mhagensiena/Cloud-Chamber-Siena-University/README.md

# Cloud-Chamber-Siena-University
The instructions to build your own desktop cloud chamber with no dry ice! All for under $200!

Download this file and open in browser:
<a href="Thorium-232%20Decay%20Chain%20Lab.html">Lab</a>
