mhagensiena/Cloud-Chamber-Siena-University/2026/overview.md

What exactly is a Cloud Chamber? How does it work? Am I really seeing particles?

A cloud chamber is a small particle detector, but you aren't seeing the particle itself. You are seeing the track left by the particle. 
The "chamber" that we create is made to reach extremely cold temperatures using devices that absorb heat such as the cooling fan and peltiers. 
The heat transfer is made more efficient using thermal paste. Then by adding the alcohol to the chamois cloth, we see alcohol vapor. 
As the particle travels through the air, the air becomes ionized, so the alcohol condenses around that air. This is how we see the track of the particle.
