mhagensiena/Cloud-Chamber-Siena-University/2026/Images/IMG_4949 2.jpeg

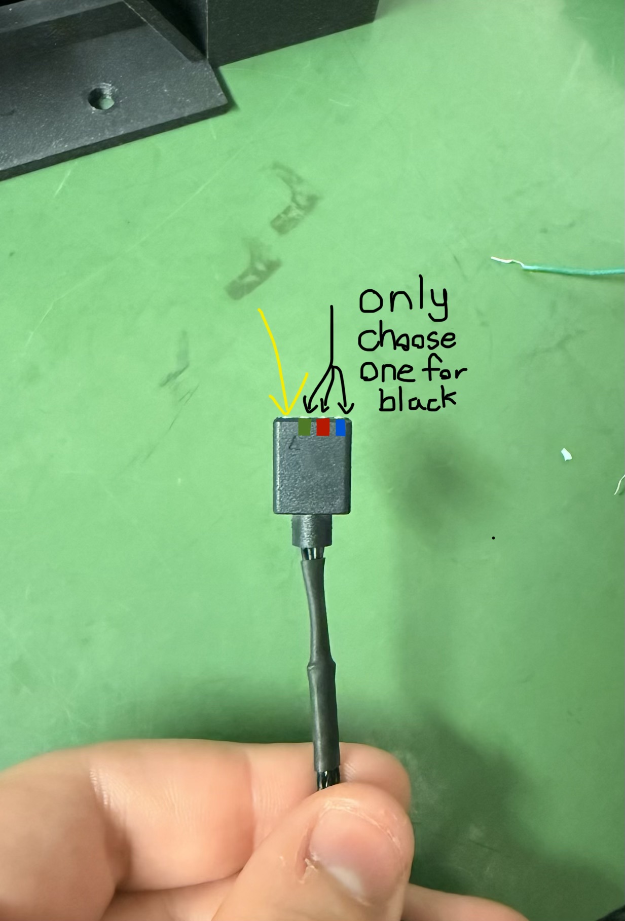
2026/Images/IMG_4949 2.jpeg
