mhagensiena/Cloud-Chamber-Siena-University/2026/Images/IMG_5046.jpeg

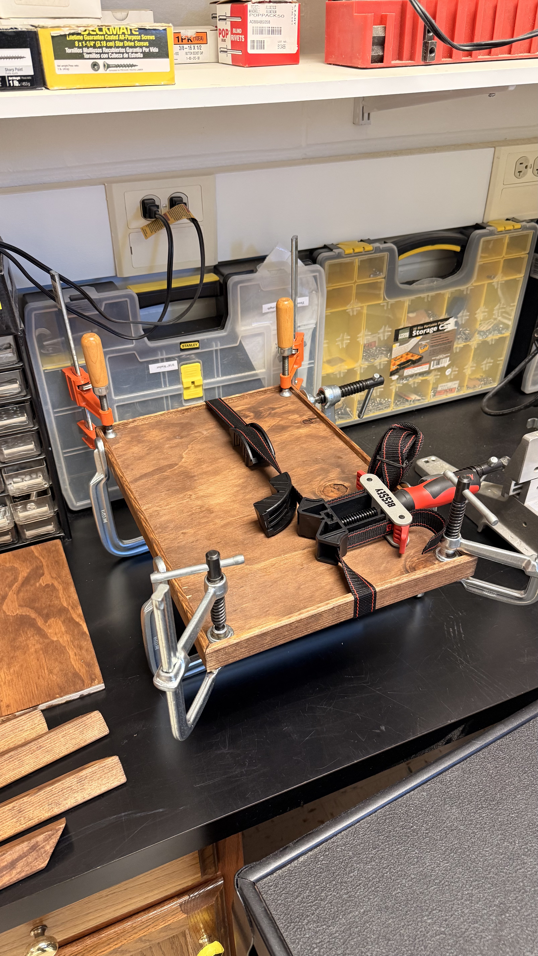
2026/Images/IMG_5046.jpeg
