mhagensiena/Cloud-Chamber-Siena-University/2026/Materials.md

# Materials & Components

<p align="center">
Everything required to build the Siena University Cloud Chamber.
</p>

---

## Quick Navigation
<h2 align="center">Quick Navigation</h2>

<p align="center"> •
  <a href="#wood--hardware">wood--hardware</a> •
  <a href="#electrical-components">electrical-components</a> •
  <a href="#cooling-components">cooling-components</a> •
  <a href="#chamber-components">chamber-components</a> •
  <a href="#recommended-tools">recommended-tools</a> •
</p>

---

<h2 id="wood--hardware" align="center">Wood & Hardware</h2>

| Component | Qty | Purchase Link |
| --- | --- | --- |
| Plywood (16" × 11", 1/2" thick minimum) | 1 | [Lowes](https://www.lowes.com/pd/1-4-in-Common-Pine-Sanded-Plywood-Application-as-2-x-2/1000068959) |
| Adjustable Feet | 4 | [Home Depot](https://www.homedepot.com/p/Everbilt-1-1-16-in-Round-Threaded-Stem-Leveling-Furniture-Glides-for-Floor-Protection-4-Pack-4603644EB/203672161)  |
| Black Handles | 2 | [Amazon](https://www.amazon.com/Cable-Lokman-Stainless-Rubber-Cushioned/dp/B01N0750PI?th=1) |
| Rubber/Wood Edging (Optional) | As Needed | [Lowes](https://www.lowes.com/pd/KidKusion-Taupe-Foam-Corner-Cushions-4-Pack-Child-Safety-Accessories-for-Tables-Countertops-and-Fireplace-Hearths/1083701) |
| #4-40 × 1" Oval Head Phillips Screws | As Needed | [Home Deopt](https://www.homedepot.com/p/Hillman-4-40-x-1-in-Phillips-Pan-Head-Machine-Screws-50-Pack-43067/204794818)  |

| #6-32 × 1" Flat Head Phillips Screws    | As Needed | [Home Deopt](https://www.homedepot.com/p/Everbilt-6-32-x-1-in-Combo-Round-Head-Zinc-Plated-Machine-Screw-100-Pack-800692/204596455)  |
| #8 × 3/4" Flat Phillips Screws          | As Needed | [Home Deopt](https://www.homedepot.com/p/Hillman-18-8-Stainless-Steel-Flat-Head-Phillips-Machine-Screw-8-32-x-3-4-in-8454/204775174 ) |

| Cable Clamp                             | 1         | [Amazon](https://www.amazon.com/Cable-Lokman-Stainless-Rubber-Cushioned/dp/B01N0750PI)                                                                      |
| Black Spray Paint                       | 1 Can     | [Walmart](https://www.walmart.com/ip/488512581)                                                                                                             |

<p align="right"><a href="#top"> Back to Top</a></p>

---

<h2 id="electrical-components" align="center"> Electrical Components</h2>

| Component | Qty | Purchase Link |
| --- | --- | --- |
| Be Quiet! PURE POWER 13 M 750W Power Supply | 1 | Existing / Retailer |
| 24-Pin Colored Adapter | 1 | [Amazon](https://www.amazon.com/ZYAMY-Female-Computer-Power-Adapter/dp/B081RPV4N6) |
| Waterproof LED Strip Lights | 1 | [Amazon](https://www.amazon.com/Flexible-Waterproof-Holiday-Outdoor-Decoration/dp/B075R4X1XL) |
| LED Strip Connectors | As Needed | [Amazon](https://www.amazon.com/Connector-Waterproof-Connectors-Transparent-Solderless/dp/B0BG41H9LJ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) |
| Lever Nuts | As Needed | [Amazon](https://www.amazon.com/dp/B08W3QXN9B) |
| Thin Wire | As Needed | Existing Supply |
| Electrical Tape | 1 Roll | [Lowes](https://www.lowes.com/pd/Scotch-700-Electrical-Tape-66-ft/50148224) |

<p align="right"><a href="#top"> Back to Top</a></p>

---

<h2 id="cooling-components" align="center"> Cooling Components</h2>

| Component | Qty | Purchase Link |
| --- | --- | --- |
| Hyper 212 RGB Black Edition Cooler | 1 | [Amazon](https://www.amazon.com/Cooler-Master-Spectrum-Brackets-RR-S4NA-17PA-R1/dp/B0BRBW94VL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) |
| TEC1-12709 Peltier Module | 1 | [Amazon](https://www.amazon.com/SMAKN-TEC1-12709-Thermoelectric-Peltier-138-6Wmax/dp/B00MTFB84Q) |
| TEC1-12710 Peltier Module | 1 |[Amazon](https://www.amazon.com/Alinan-TEC1-12709-Semiconductor-Refrigeration-Thermoelectric/dp/B09M7V92WK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) |
| Arctic Silver 5 or Arctic MX-5 Thermal Paste | 1 Tube | [Amazon](https://www.amazon.com/Arctic-Silver-AS5-3-5G-Thermal-Paste/dp/B000OGX5AM) |

<p align="right"><a href="#top"> Back to Top</a></p>

---

<h2 id="chamber-components" align="center"> Chamber Components</h2>

| Component | Qty | Purchase Link |
| --- | --- | --- |
| 100 mm Petri Dish | 1 | [Amazon](https://www.amazon.com/Disposable-Petri-Dish-35mm-Polystyrene/dp/B07WLLB2XB) |
| Chamois Cloth | 1 | [Amazon](https://www.amazon.com/AmazonBasics-Drying-Chamois-2-Pack/dp/B00EVY344K) |
| Isopropyl Alcohol (90%+) | 1 Bottle  | [Amazon](https://www.amazon.com/Amazon-Brand-Isopropyl-Alcohol-Antiseptic/dp/B07NFTZ522) |
| Thoriated Tungsten Rod | 1 | [Tungsten.com](https://shop.tungsten.com/tig-welding-electrodes-10-pack) |
| Super Glue | 1 | Local Retailer |
| Washers | As Needed | [Home Deopt](https://www.homedepot.com/p/Everbilt-6-Zinc-Plated-Flat-Washer-100-Pieces-19792/202249725#see-more-details) |

<p align="right"><a href="#top"> Back to Top</a></p>

---

<h2 id="recommended-tools" align="center"> Recommended Tools</h2>

* Drill
* Assorted Drill Bits
* Soldering Iron
* Solder
* Wire Strippers
* Phillips Screwdriver
* Measuring Tape
* Clamps
* Saw
* Utility Knife
* Infrared Thermometer (Recommended)
* Hot Glue Gun (Optional)

---

> [!TIP]
> Before beginning assembly, verify that all materials and tools are available. Having everything prepared beforehand will make the build process significantly smoother.

> [!WARNING]
> This project involves electrical wiring, soldering, sharp tools, and a radioactive source. Follow all applicable safety procedures and work in a safe, well-ventilated environment.
