mhagensiena/Cloud-Chamber-Siena-University/2026/3D print parts/Cooler Fan Holder.stl

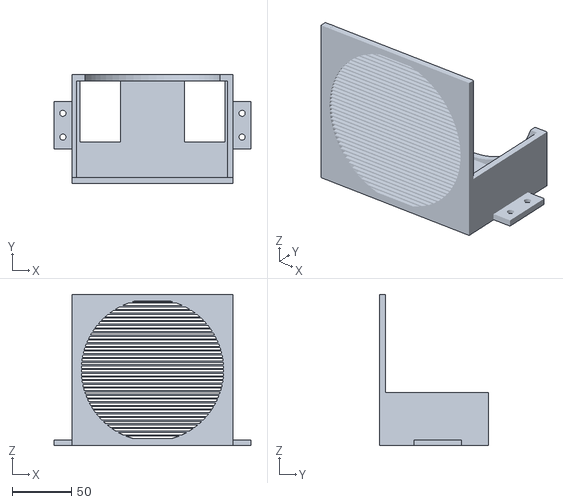
[picture p3: CAD file, 2026-06-12]
2026/3D print parts/Cooler Fan Holder.stl
166.3 x 91.6 x 127.6
