mhagensiena/Cloud-Chamber-Siena-University/2026/3D print parts/Power_Supply_Holder_Be_Quiet.stl

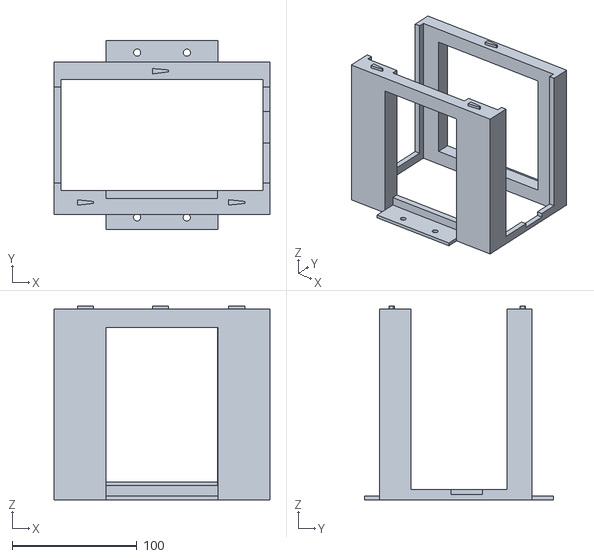
[picture p4: CAD file, 2026-06-10]
2026/3D print parts/Power_Supply_Holder_Be_Quiet.stl
173.2 x 151.9 x 155.5
