mhagensiena/Cloud-Chamber-Siena-University/2026/3D print parts/Led_Holder.stl

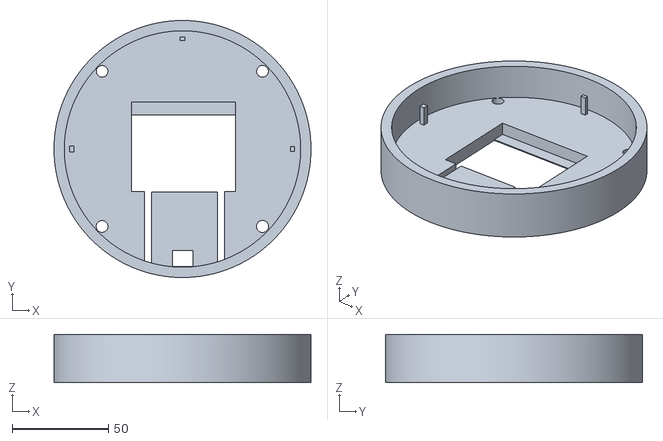
[picture p5: CAD file, 2026-06-08]
2026/3D print parts/Led_Holder.stl
133.8 x 133.8 x 25.0
