mhagensiena/Cloud-Chamber-Siena-University/2026/3D print parts/Led_cover.stl

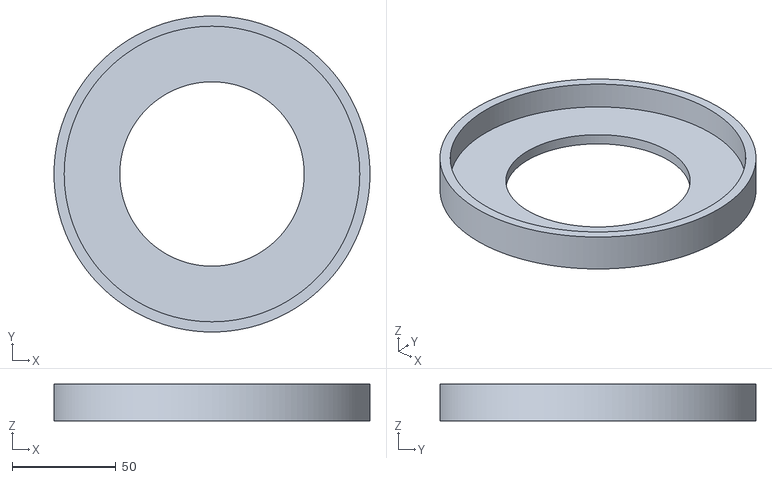
[picture p6: CAD file, 2026-06-08]
2026/3D print parts/Led_cover.stl
152.4 x 152.4 x 17.8
