mhagensiena/Cloud-Chamber-Siena-University/2016/Instructions.md

Here is a link to the instructions for 2016

 <a href="https://www.instructables.com/Cloud-Chamber-Particle-Detector/">2016 Instructions </a>
