mhagensiena/Cloud-Chamber-Siena-University/2022/instructions.md

Here is a link to the instructions from 2022

 <a href="https://https://www.instructables.com/Cloud-Chamber-Particle-Detector-2022/">2022 Instructions </a>
