mhagensiena/Cloud-Chamber-Siena-University/2025/instructions.md

Here is a link to the instructions from 2025

  <a href="https://www.instructables.com/Siena-College-Cloud-Chamber-2025/"> 2025 Instructions</a>
