mhagensiena/Cloud-Chamber-Siena-University/2026/Lab instructions.docx

# General Lab Procedures

Data Acquisition and Calibration

- Review the accompanying presentation slides [https://docs.google.com/presentation/d/1B35zL_IkINuuKQ8NIXFKNZCMMRDfD0Q6fm9fiU3JGMw/edit?usp=sharing] on data collection and analysis, as the procedures are applicable to both the Lead-210 and Cosmic Ray segments of this lab.
- Calibration Procedure: The Tracker software (https://opensourcephysics.github.io/tracker-website/) provides particle track data in pixels. To convert pixel measurements to centimeters (cm), an object of known size within the Petri dish must be measured to establish the pixels-to-cm conversion factor.
- Data Archival: All raw video files and processed data spreadsheets must be uploaded to the shared drive location (https://drive.google.com/drive/folders/1GYDYQL0rpfoI6Ljsu8_pguHJivwzpHmI?usp=drive_link)

Background Physics and Theory

- The provided presentation slides [https://docs.google.com/presentation/d/1Ke5z5PG0GqcO819rRQGf8dI0Vj1WmEbkjeAe4o_L0DA/edit?usp=sharing] cover the foundational physics and initial data analysis techniques for this experiment. Successful completion of this upper-level lab requires independent research beyond the provided materials.

# Laboratory Techniques extra material

Cosmic Ray Background Measurement

- Objective: Estimate the angular distribution of cosmic rays.
1. Data Collection (Background): Acquire multiple video recordings of the cloud chamber in the absence of the radioactive source. The goal is to detect high-energy cosmic ray tracks, characterized by strong, definite ionization paths.
  - Operational Note: Cosmic ray tracks are typically visible every 30–60 seconds. Record sufficient video time to collect a minimum of 30 distinct tracks. Excessive alcohol condensation requires wiping down the lid and possibly reapplying alcohol to the chamber.
2. Calibration Check: Confirm that the calibration required for converting pixel measurements to track length remains consistent.
3. Track Recording: Record the timestamp for each of the collected cosmic ray tracks.
4. Data Analysis & Plotting:
  - Generate a plot showing the trajectory of all observed tracks.
  - Plot the arrival time of each track versus its measured track length.
5. Angular Distribution: Estimate the incoming angle of the cosmic ray based on the track length, as discussed in the lab session. Plot the resulting angular distribution. Note: Given the minimum target of 30 tracks, the binning may be coarse.
6. Discussion Points:
  - Identify and discuss the factors that influence the accuracy of the estimated angular distribution.
  - Describe the expected shape of the angular distribution based on theoretical models and previous lab discussions.
