mhagensiena/Cloud-Chamber-Siena-University/(commit log)

2026-06-05 Add overview of cloud chamber functionality
2026-06-05 Add materials list for 2026 project
2026-06-05 Create 3D printed parts
2026-06-05 instructions for cloud chamber assembly
    Added detailed step-by-step instructions for building a cloud chamber, including preparation, assembly, and testing procedures.
2026-06-05 troubleshooting guide
    Added troubleshooting guide for common issues related to power supply, fan, peltier, LEDs, particle tracks, and mist visibility.
2026-06-08 3D printed STL Files
    [Power_Supply_Lid_Be Quite.stl, led_cover.stl, led_holder.stl, power_supply_holder_Be Quite.stl]
2026-06-08 moved stl files into their own filder
    [Power_Supply_Lid_Be Quite.stl, led_cover.stl, led_holder.stl, power_supply_holder_Be Quite.stl]
2026-06-09 Enhance instructions with detailed assembly guide
    Added a step-by-step guide for assembling and testing the Siena University 2026 Cloud Chamber.
2026-06-09 Revise instructions formatting for clarity
    Updated the formatting and structure of the instructions for assembling and testing the 2026 Cloud Chamber, including section headings and navigation links.
2026-06-09 Revise materials list and add navigation section
    Updated the materials list for the Siena University Cloud Chamber project, including sections for wood, electrical, cooling, and chamber components. Added a quick navigation section for easier access to different components.
2026-06-09 Enhance troubleshooting guide for cloud chamber
    Expanded troubleshooting guide for cloud chamber issues, including detailed checks for power supply, fan, Peltier, LEDs, and particle track visibility.
2026-06-09 Enhance wiring instructions and add image reference
    Added an image reference for fan light connections and clarified wiring instructions.
2026-06-09 Fix image source and enhance LED wiring instructions
    Updated image source in instructions and clarified wiring steps for LED connections.
2026-06-09 Fix HTML formatting in Materials.md
2026-06-09 Update back to top links in Instructions.md
    Replaced '⬆ Back to Top' with 'Back to Top' for consistency.
2026-06-10 dleating old powersuply holder
    [Power_Supply_Lid_Be Quite.stl]
2026-06-12 removed old 3d print
2026-06-12 removed wrong stl file
    [Cooler Fan Holder.stl, cooler_fan_holder (1).stl]
2026-06-15 Update purchase links for materials in 2026/Materials.md
2026-06-16 removede old poweer supply holder
    [power_supply_holder_Be Quite.stl]
2026-06-25 Enhance instructions with image and wire labeling details
    Added an image and updated instructions for labeling wires in the power supply setup.
2026-06-25 Revise steps 8 to 19 in Instructions.md
    Updated step headings and removed obsolete instructions for mounting the D6SEC fan.
2026-07-15 removed old file
    [Power_suply_holder_lid.stl]
2026-07-21 Fix typos and enhance soldering instructions
    Corrected typos and improved clarity in soldering instructions. Added links for tutorials and clarified steps for connecting wires.
